imanenferadi/dual-rail-power-supply/arduino-oscilloscope/photos/bridge-rectifier-schematic.png

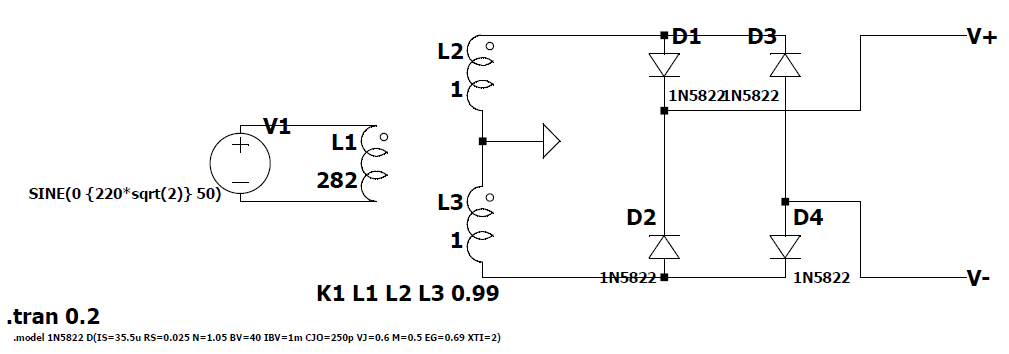
arduino-oscilloscope/photos/bridge-rectifier-schematic.png
