imanenferadi/dual-rail-power-supply/arduino-oscilloscope/photos/filter-before-after.png

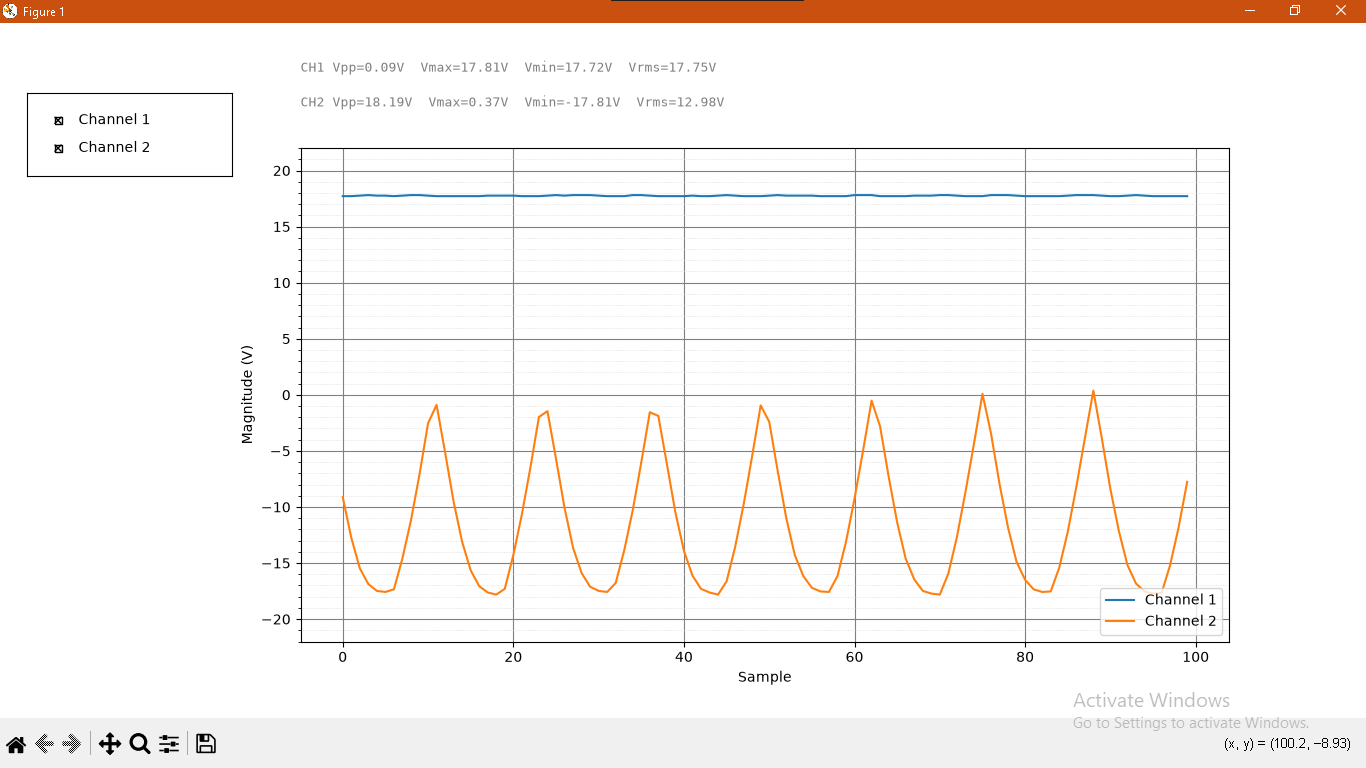
arduino-oscilloscope/photos/filter-before-after.png
