imanenferadi/dual-rail-power-supply/power-supply/photos/output-test-croc-clips-2.jpg

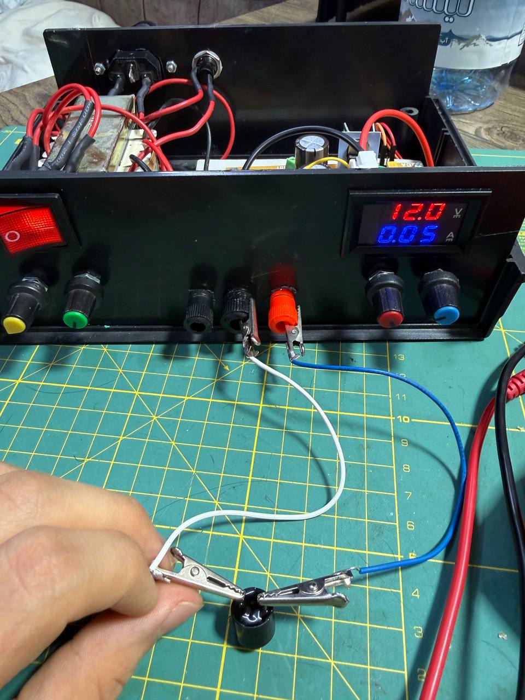
power-supply/photos/output-test-croc-clips-2.jpg
