imanenferadi/dual-rail-power-supply/power-supply/schematics/schematic.pdf

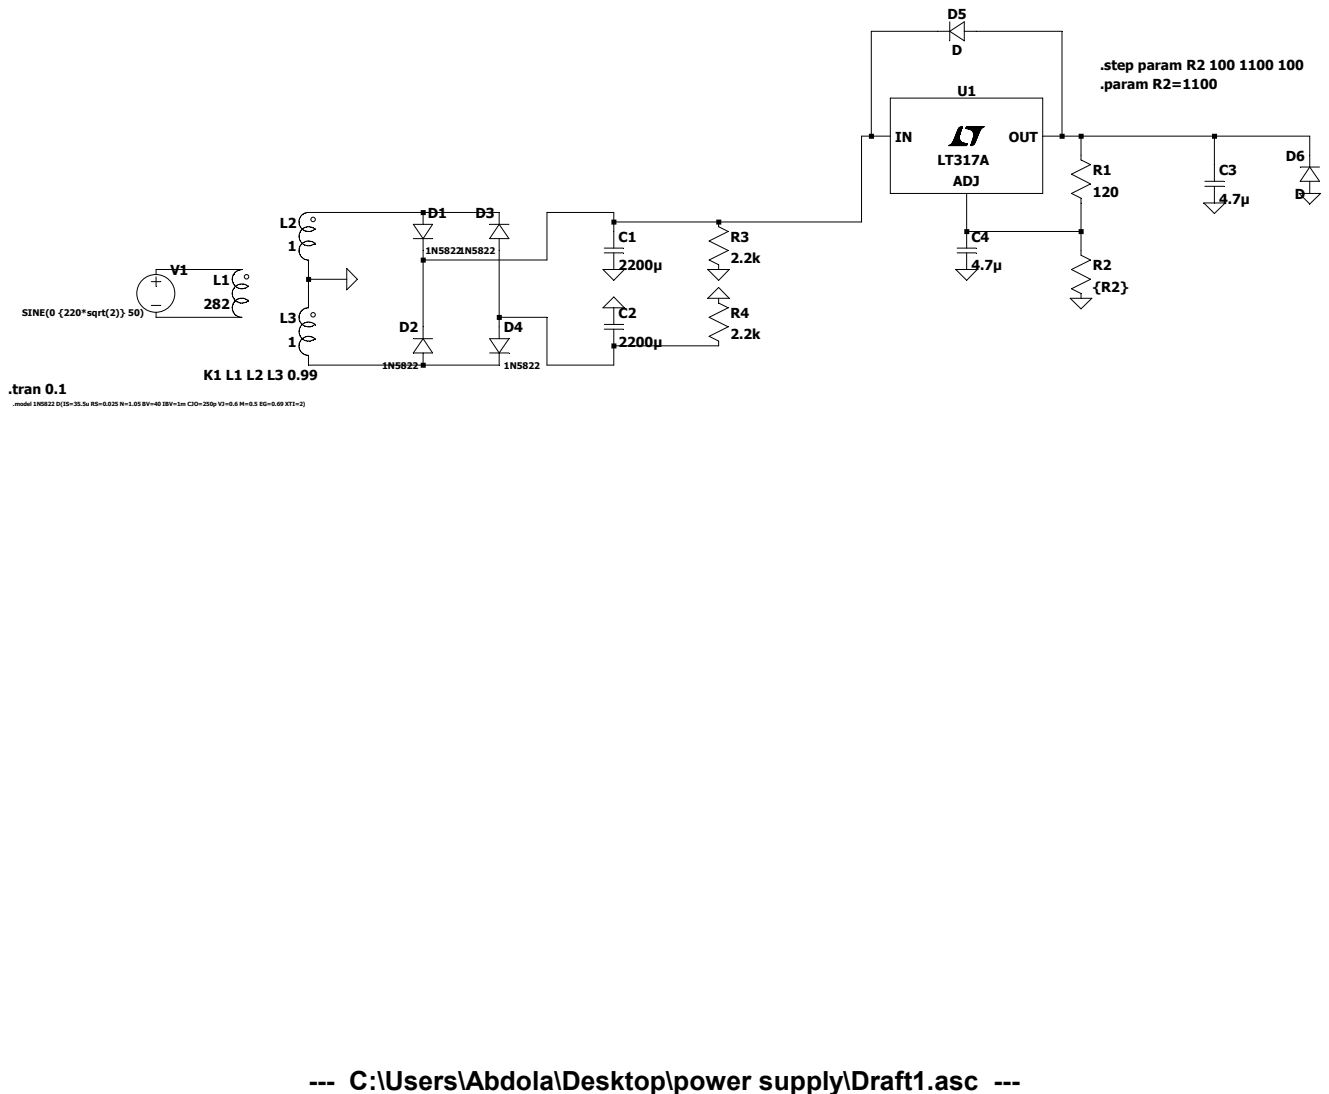
[picture p26: page 1]

.model 1N5822 D(IS=35.5u RS=0.025 N=1.05 BV=40 IBV=1m CJO=250p VJ=0.6 M=0.5 EG=0.69 XTI=2)

--- C:\Users\Abdola\Desktop\power supply\Draft1.asc ---
