imanenferadi/dual-rail-power-supply/power-supply/schematics/schematic.asc

C1: cap; 2200µ
C2: cap; 2200µ
C3: cap; 4.7µ
C4: cap; 4.7µ
D1: diode; 1N5822
D2: diode; 1N5822
D3: diode; 1N5822
D4: diode; 1N5822
D5: diode
D6: diode
L1: ind; 282; Rser=0.1
L2: ind; 1; Rser=0.1
L3: ind; 1; Rser=0.1
R1: res; 120
R2: res; {R2}
R3: res; 2.2k
R4: res; 2.2k
U1: LT317A
V1: voltage; SINE(0 {220*sqrt(2)} 50)
Named nets: 0
.tran 0.1
K1 L1 L2 L3 0.99
.model 1N5822 D(IS=35.5u RS=0.025 N=1.05 BV=40 IBV=1m CJO=250p VJ=0.6 M=0.5 EG=0.69 XTI=2)
.param R2=1100
.step param R2 100 1100 100
