imanenferadi/dual-rail-power-supply/(commit log)

2026-09-20 Add dual-rail adjustable power supply + Arduino oscilloscope project
2026-09-20 Add lab report PDF; swap in the oscilloscope script that matches the report's code appendix
    [oscilloscope.py]
2026-09-20 Remove public report PDF, fix voltage spec to match measured value
2026-09-20 Credit Dr. Alavi's handout for the regulator topology
2026-09-20 Add the Vrms/Vpeak safety-margin story, fill out the Schottky diode reasoning
2026-09-20 Remove the early-revision level shifter board photo
2026-09-20 Rewrite README as a structured engineering write-up; fix stale oscilloscope resolution figure and resistor-change story
2026-09-20 Clarify the schematic shows only the positive rail
2026-09-20 Fix caption: final-unit-display.jpg is a short-circuit test, not a generic display shot
